JustCryen/STM32-HID-H.O.T.A.S/docs/Schematic-HOTAS-page1.png

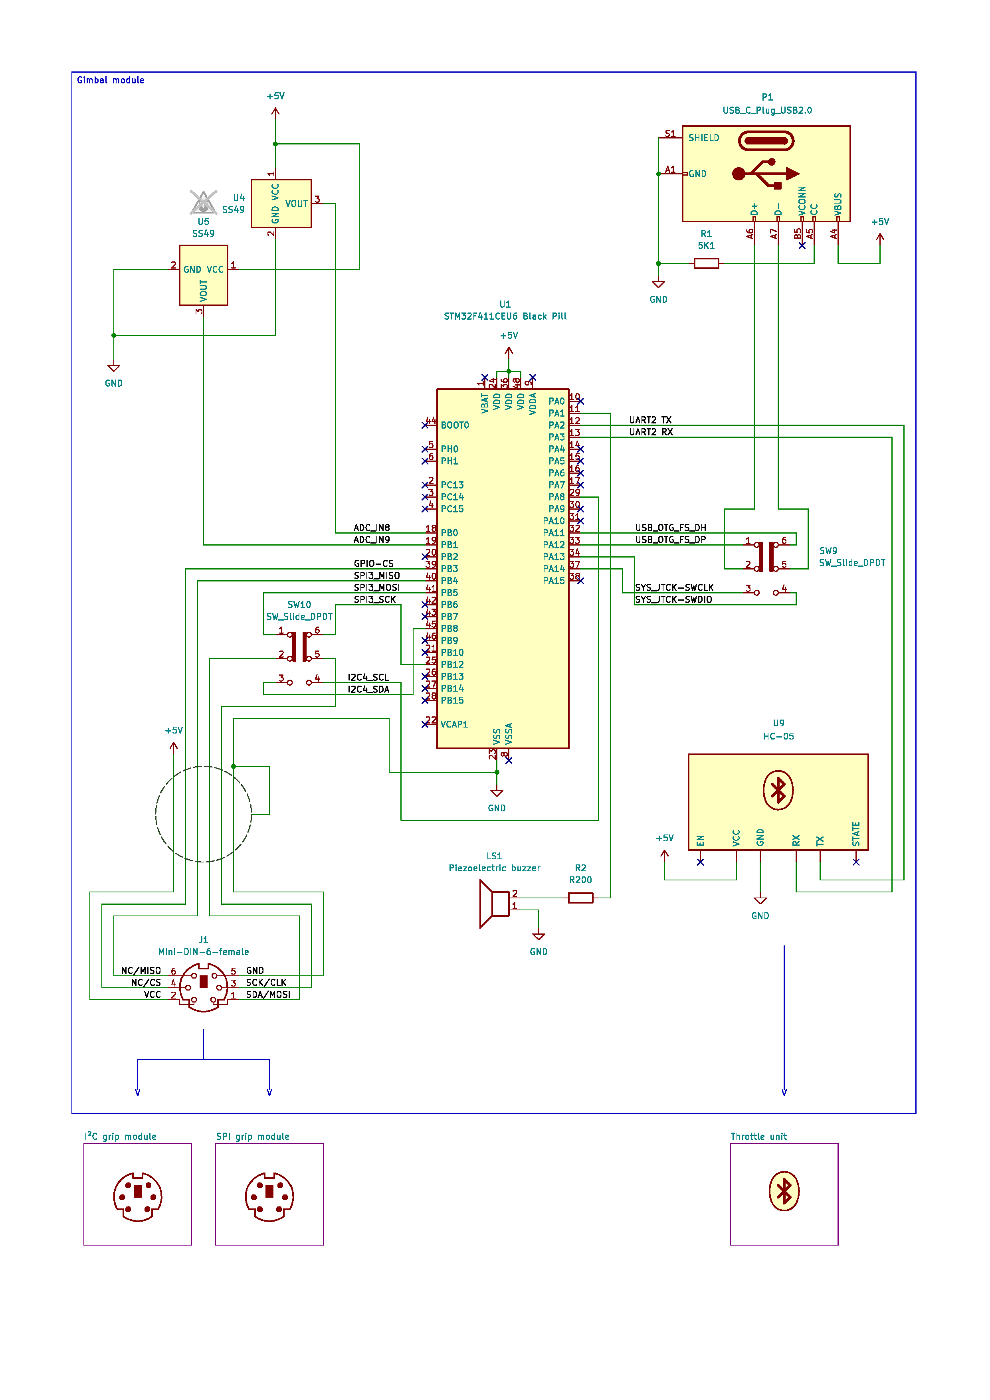
docs/Schematic-HOTAS-page1.png
