JustCryen/STM32-HID-H.O.T.A.S/docs/Schematic-HOTAS-page2.png

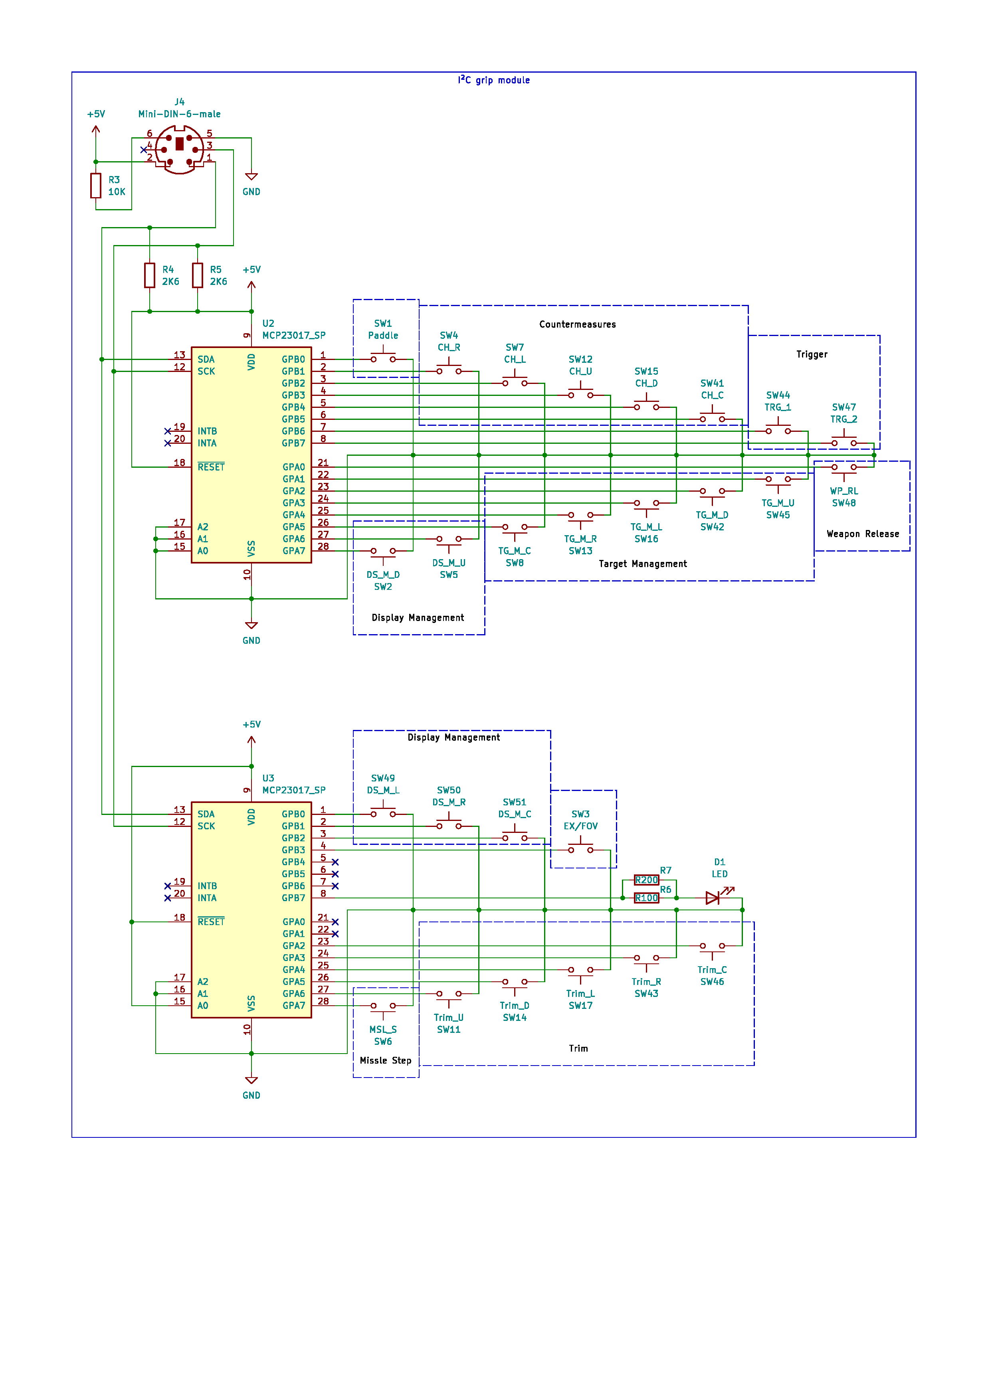
docs/Schematic-HOTAS-page2.png
