JustCryen/STM32-HID-H.O.T.A.S/docs/Schematic-HOTAS-page3.png

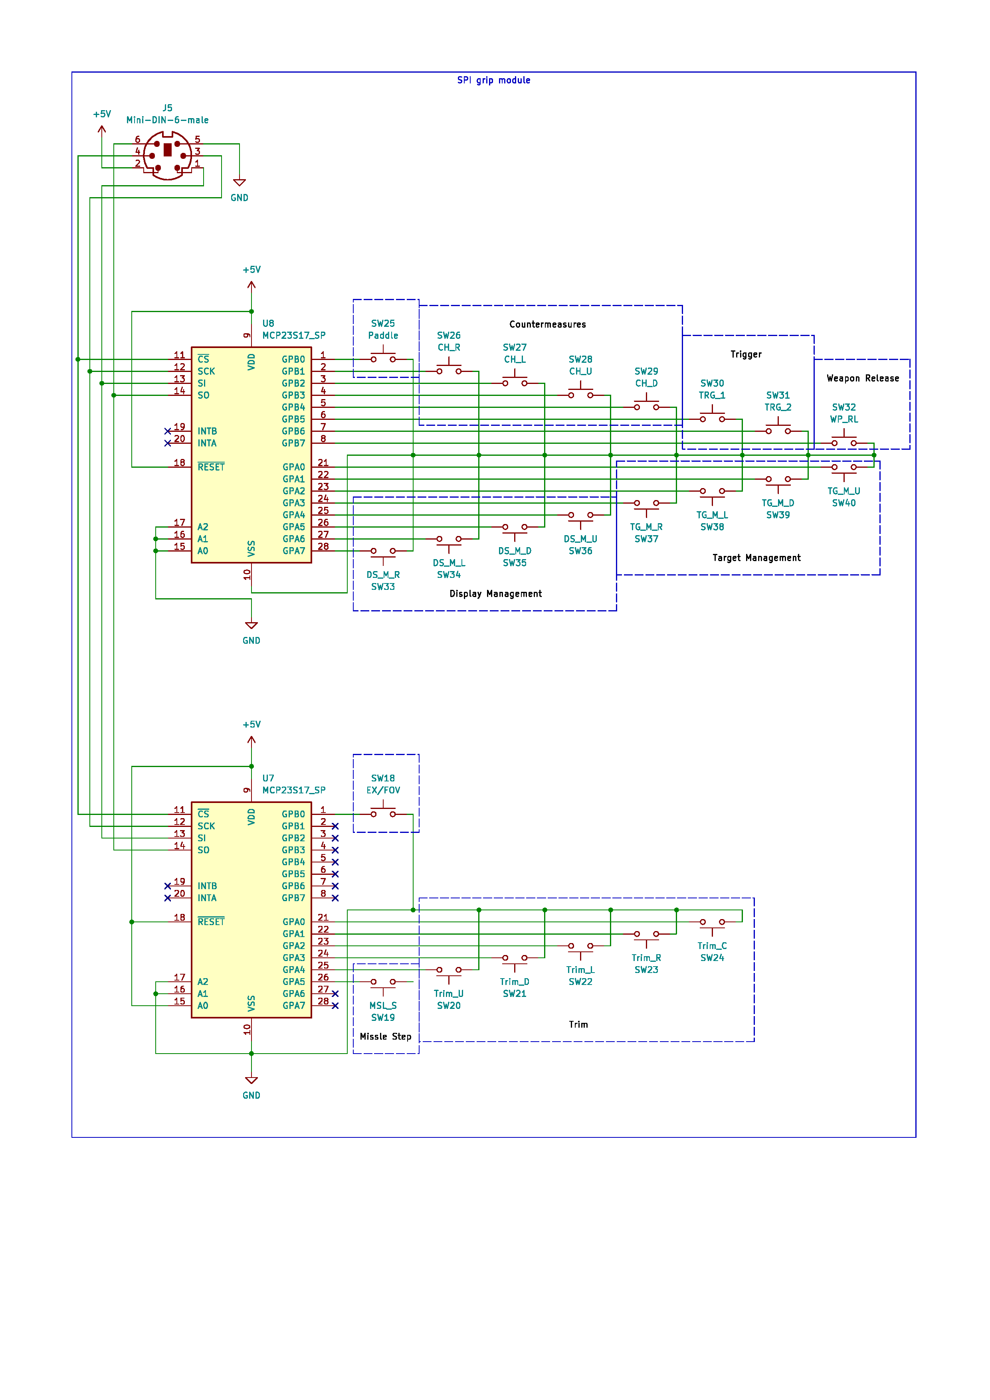
docs/Schematic-HOTAS-page3.png
