JustCryen/STM32-HID-H.O.T.A.S/docs/Schematic-HOTAS-page4.png

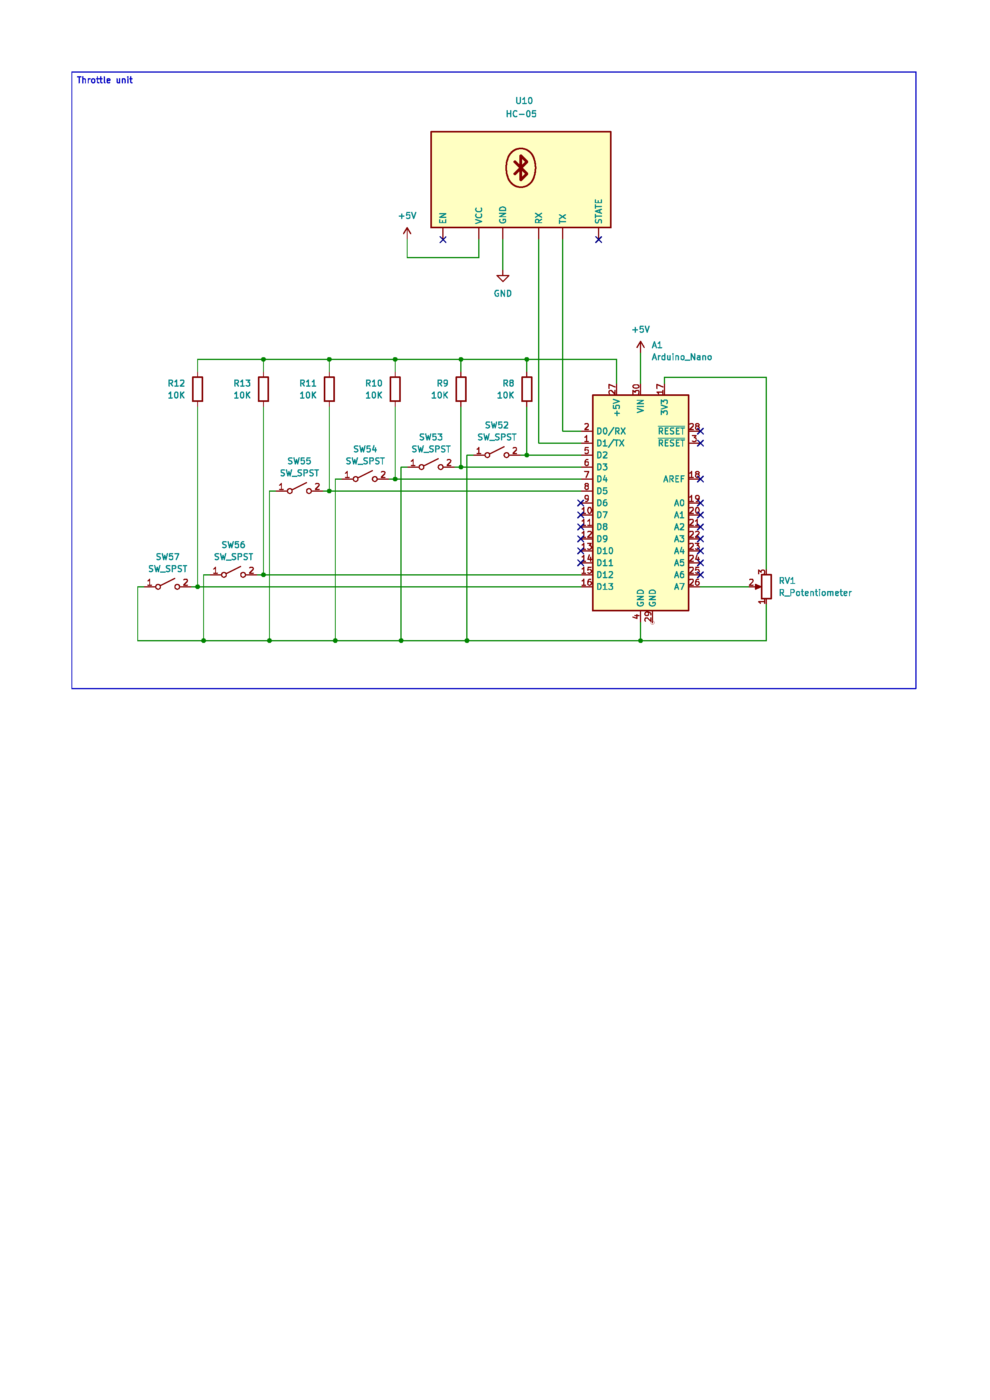
docs/Schematic-HOTAS-page4.png
