JustCryen/STM32-HID-H.O.T.A.S/docs/Schematic-HOTAS.pdf

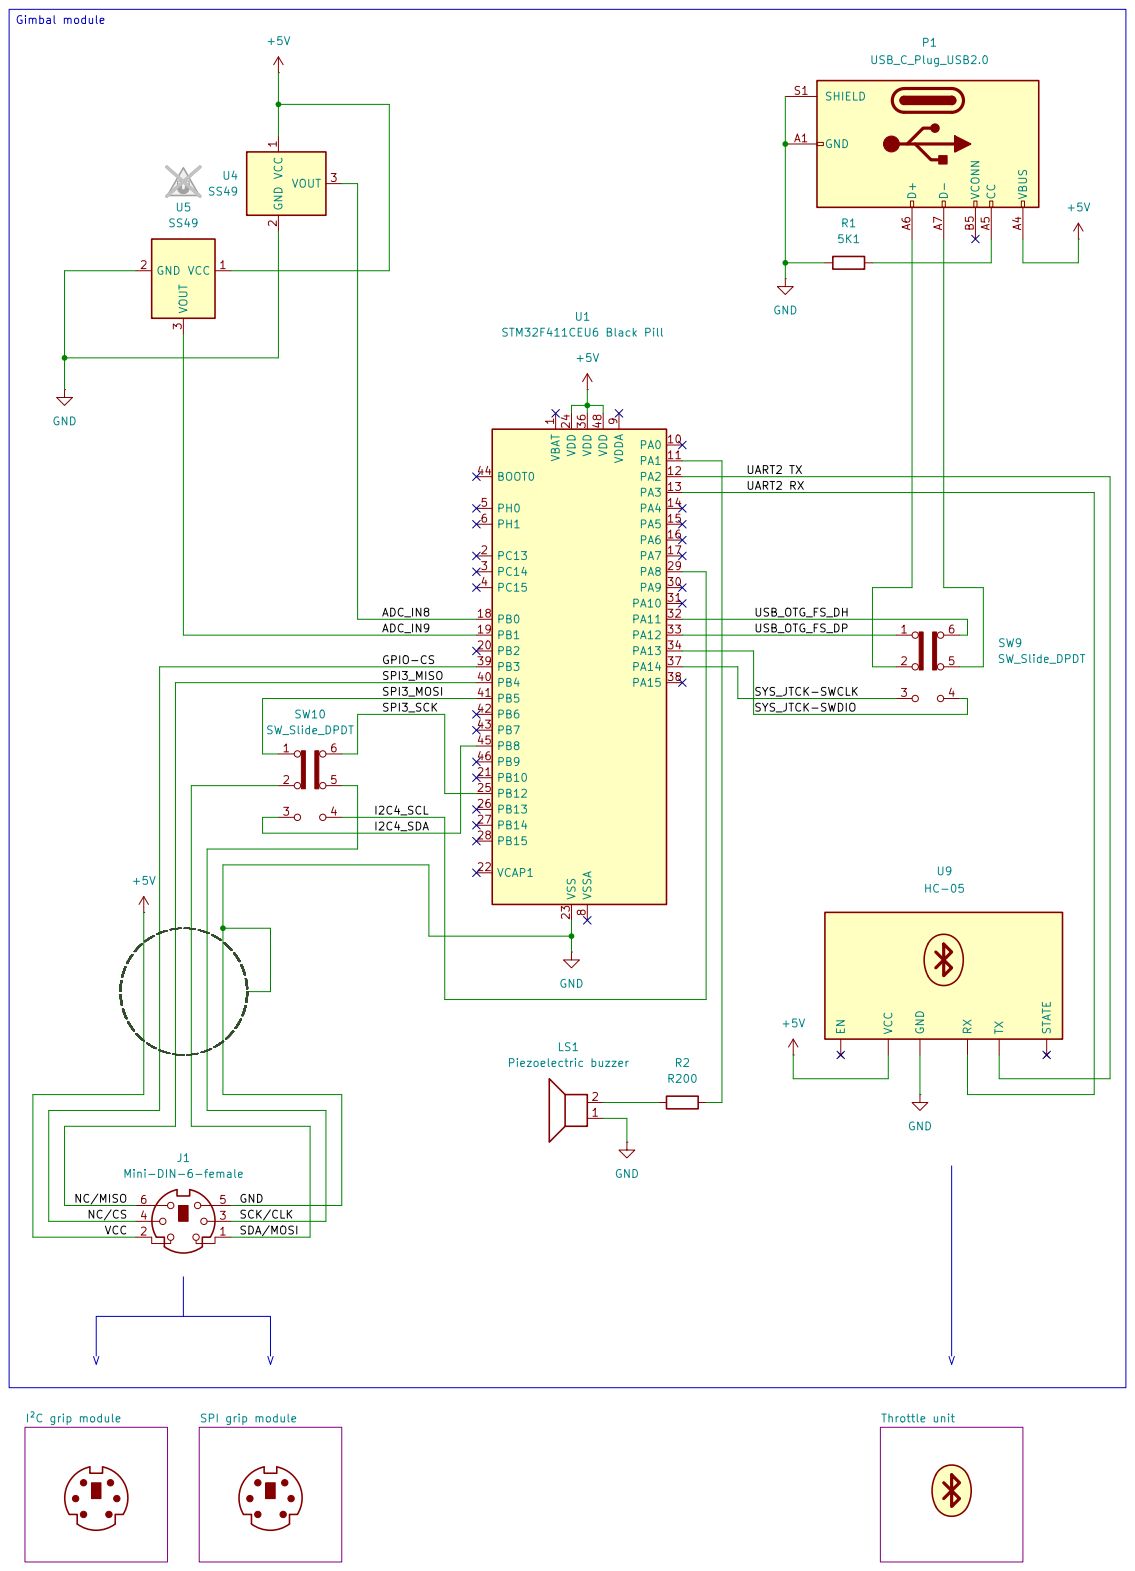
[picture p5: page 1]

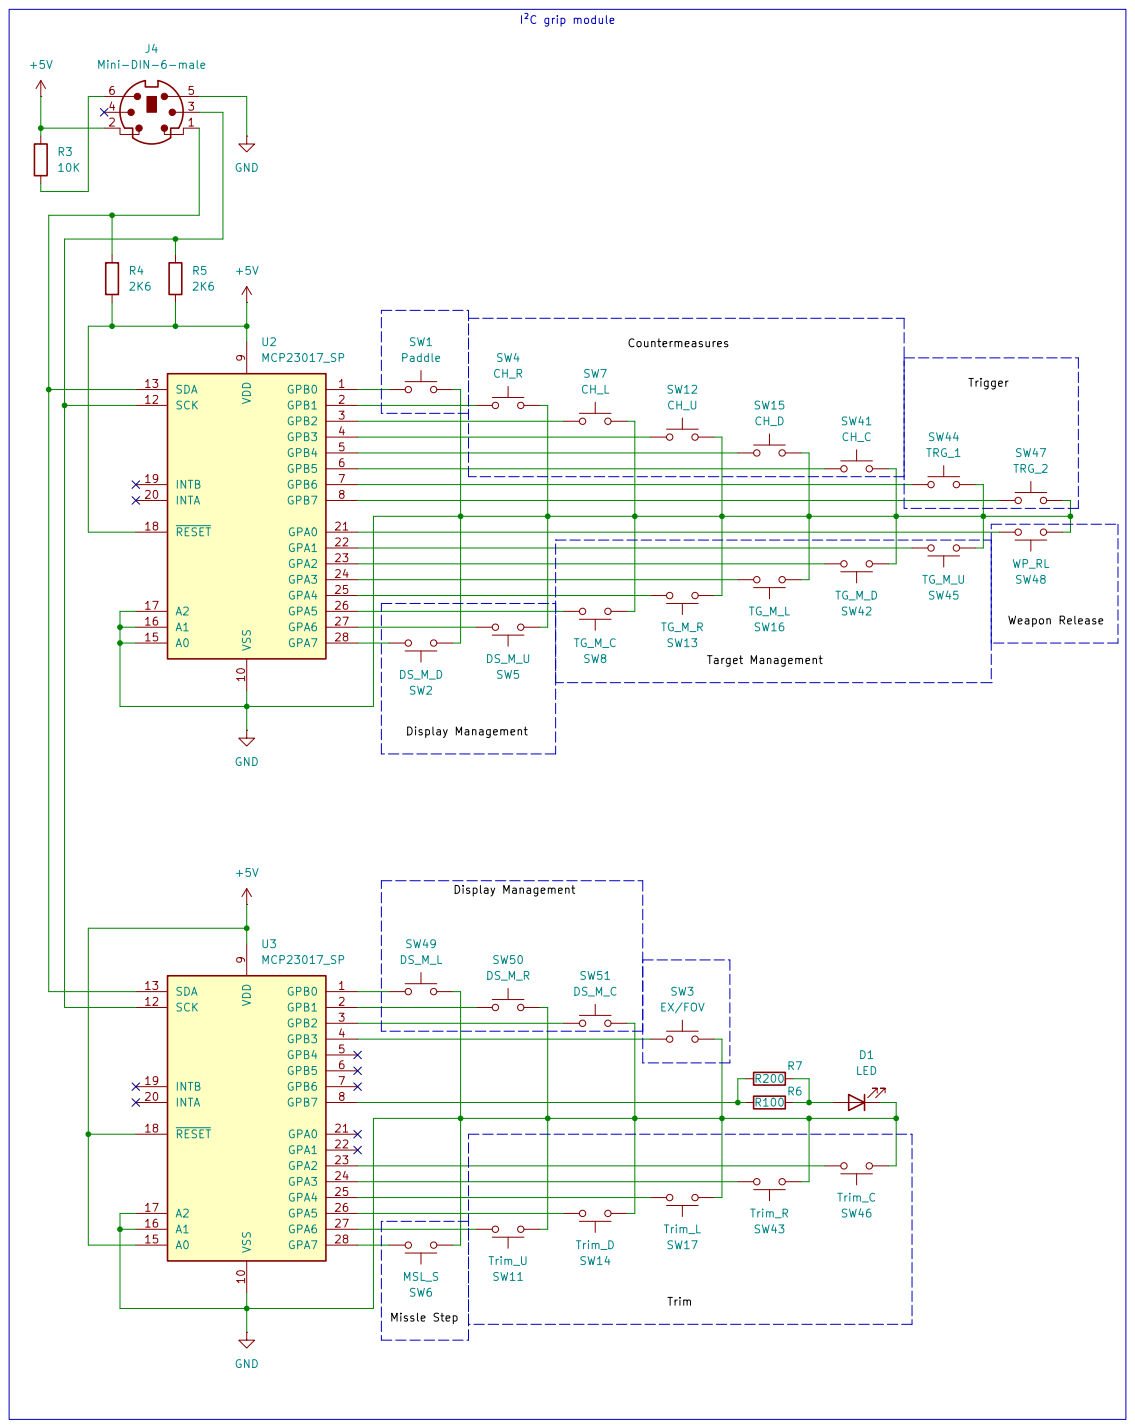
[picture p6: page 2]

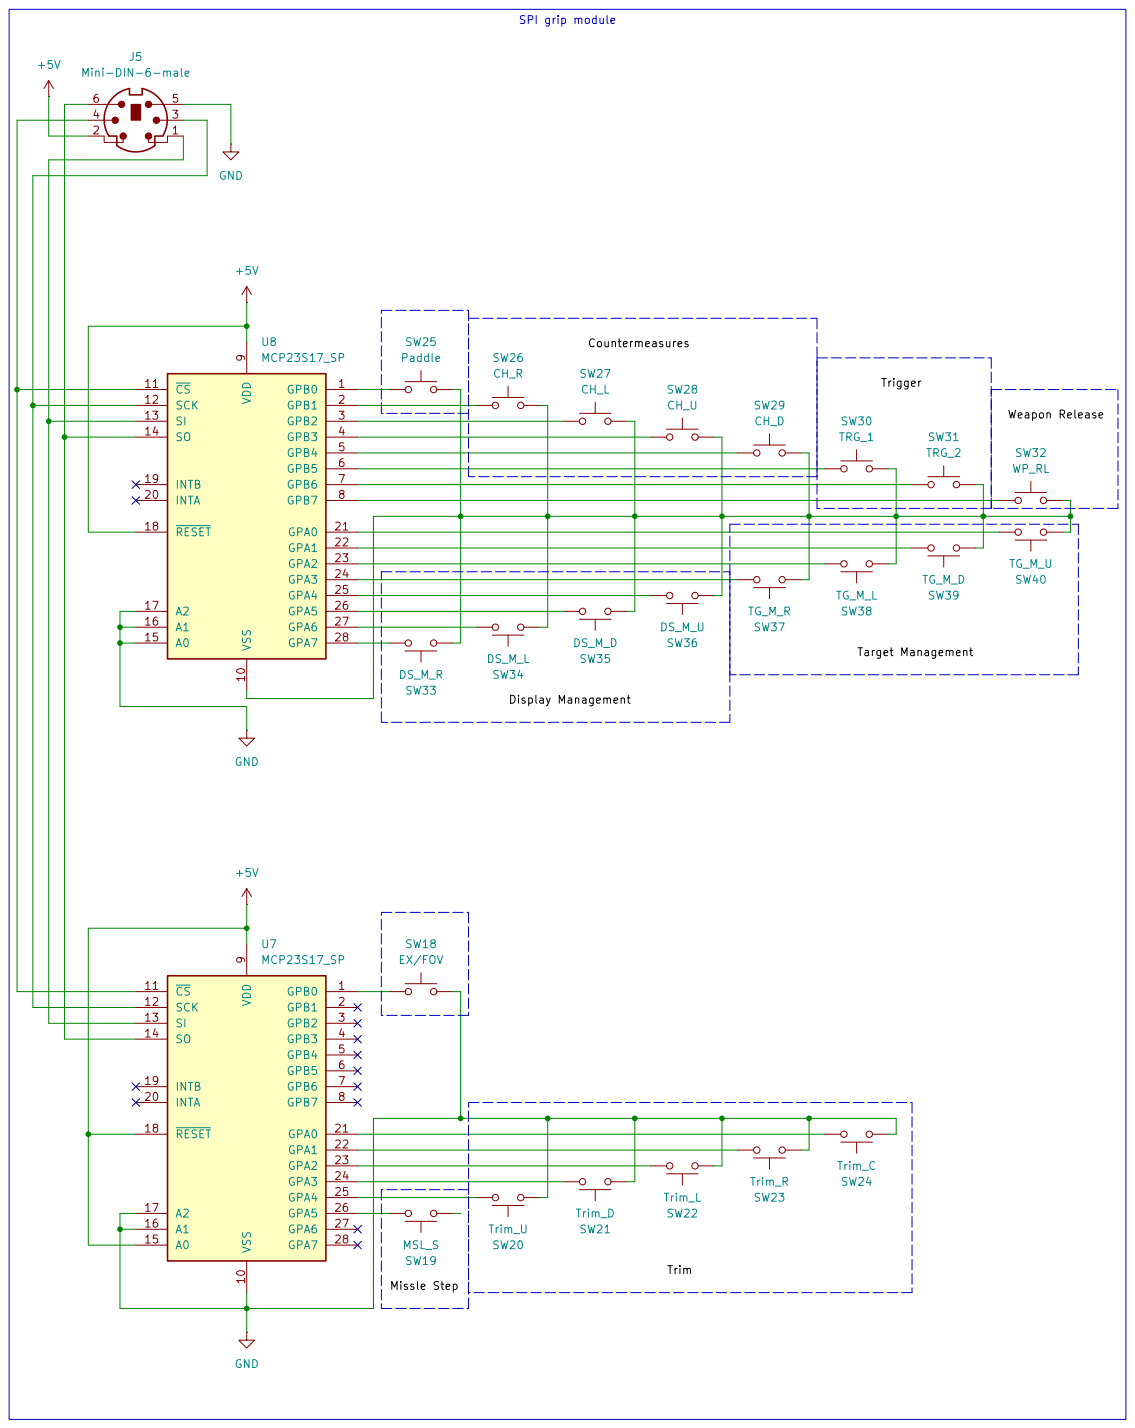
[picture p7: page 3]

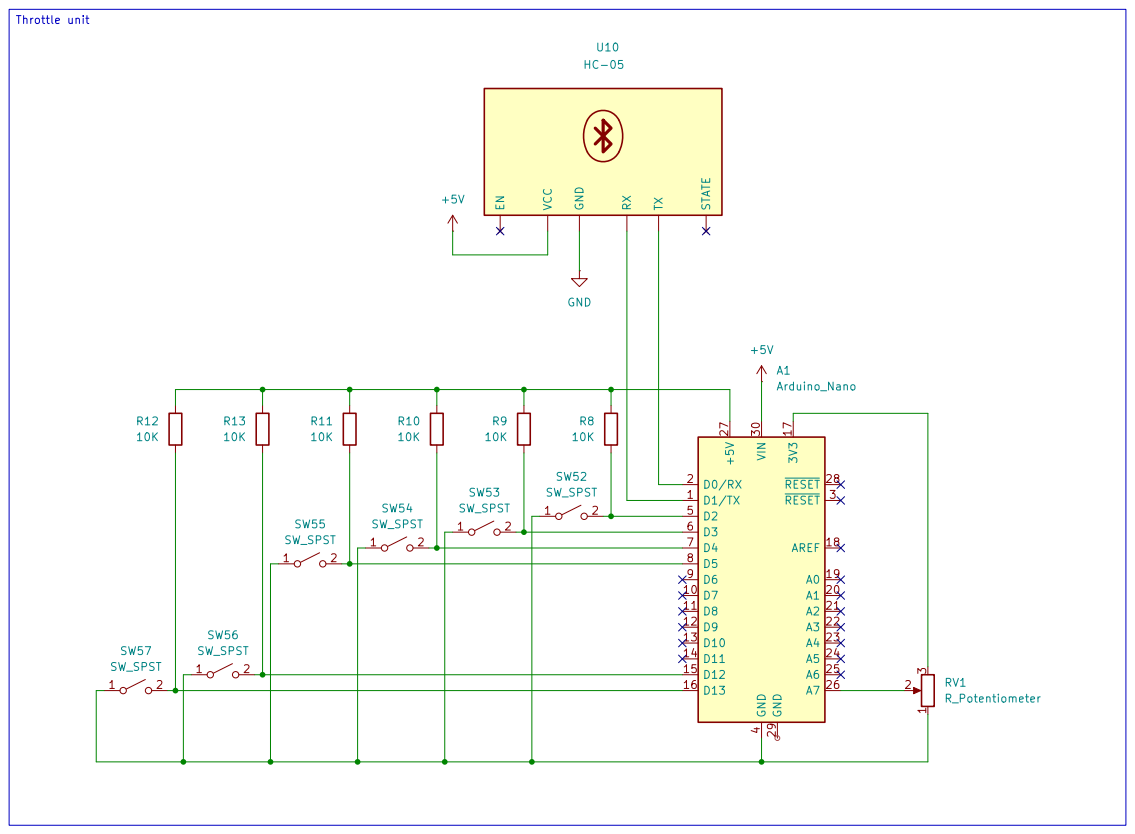
[picture p8: page 4]
