JustCryen/STM32-HID-H.O.T.A.S/HID-Hotas/Core/Src/main.c

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
/* Includes ------------------------------------------------------------------*/
#include "main.h"
#include "adc.h"
#include "dma.h"
#include "i2c.h"
#include "spi.h"
#include "tim.h"
#include "usart.h"
#include "usb_device.h"
#include "gpio.h"

/* USER CODE BEGIN Includes */
// #define serial_MCP23S17
// #define serial_MCP23017
#include "tunes.c"
#include "serial.c"
#include "usbd_customhid.h"
#include "math.h"
/* USER CODE END Includes */


/* USER CODE BEGIN PV */
uint16_t ADC_buffer[2];
/* USER CODE END PV */

void SystemClock_Config(void);
/* USER CODE BEGIN 0 */
extern USBD_HandleTypeDef hUsbDeviceFS;

int centering(uint16_t probed, uint16_t correction)
{
  uint16_t result;
  if (probed < correction)
  {
    result = (4095 - (((probed - 1056)* 2048) / (correction - 1056)));
  }
  else
  {
    result = (4095 - ((((probed - correction)* 2048) / (4095 - correction)) + 2048));
  }
  return result;
}
int expo(uint16_t probed2, uint16_t correction2)
{
  uint16_t x = centering(probed2, correction2);
  uint16_t result2;
  if (abs(x-2048) < 64)
  {
	result2 = 2048/16;
  }
  else
  {
	if (x > 2048)
	{
		result2 = ( 64 * exp((( x)-2048) / (510.0) ) + 2048)/16;
		if (result2 > 255) result2 = 255;
	}
	else
	{
		result2 = (-64 * exp(((-x)+2048) / (510.0) ) + 2048)/16;
	}
  }
  return result2;
}
/* USER CODE END 0 */

/**
  * @brief  The application entry point.
  * @retval int
  */
int main(void)
{
  /* USER CODE BEGIN 1 */
  uint8_t Joystick_buffer[7];
  uint8_t Extender_raw[4];
  uint16_t x_correction;
  uint16_t y_correction;
  uint8_t ThrottleBT[5] = {0};
  uint16_t Throttle = 0x00;
  uint16_t ThrottleButtons = 0xFF;
  uint16_t heartbit_delay = 50;
  /* USER CODE END 1 */

  /* MCU Configuration--------------------------------------------------------*/

  /* Reset of all peripherals, Initializes the Flash interface and the Systick. */
  HAL_Init();

  /* Configure the system clock */
  SystemClock_Config();

  /* Initialize all configured peripherals */
  MX_GPIO_Init();
  MX_DMA_Init();
  MX_USB_DEVICE_Init();
  MX_ADC1_Init();
  MX_SPI3_Init();
  MX_USART2_UART_Init();
  MX_I2C3_Init();
  MX_TIM4_Init();
  /* USER CODE BEGIN 2 */

  Joystick_buffer[0] = 0; // T
  Joystick_buffer[1] = 0; // X
  Joystick_buffer[2] = 0; // Y
  Joystick_buffer[3] = 0; // Extender
  Joystick_buffer[4] = 0; // Extender
  Joystick_buffer[5] = 0; // Extender
  Joystick_buffer[6] = 0; // Extender
  HAL_TIM_PWM_Start(&htim4, TIM_CHANNEL_4);
  tune_init();
  HAL_ADC_Start_DMA(&hadc1, (uint32_t*) ADC_buffer, 2);
  HAL_Delay(1000);
  x_correction = ADC_buffer[0];
  y_correction = ADC_buffer[1];
  setup_MCP23X17();
  if (protocol) {
	MCP23X17_write(IO_DEVICE_1, MCP_OLATB, 0x40);
  }
  /* USER CODE END 2 */

  /* Infinite loop */
  /* USER CODE BEGIN WHILE */
  while (1)
  {
    /* USER CODE END WHILE */

    /* USER CODE BEGIN 3 */
    if (heartbit_delay > 0)
	  heartbit_delay -= 1;
	else {
      tune_heartbeat();
	  heartbit_delay = 100;
	}

    if (HAL_GPIO_ReadPin(GPIOA, GPIO_PIN_0) == 0) {
	  setup_MCP23017();
      x_correction = ADC_buffer[0];
      y_correction = ADC_buffer[1];
	  tune_calibrated();
	}

    HAL_UART_Receive_DMA(&huart2, ThrottleBT, 5);
    if (ThrottleBT[0] == 'z')				// detect Z axis data packet
    {
      ThrottleBT[0] = '0';					// rewrite x as 0 to be able to convert char to int
      Throttle = atoi((char*) ThrottleBT);
    } else if (ThrottleBT[0] == 'b')		// detect buttons data packet
    {
      ThrottleBT[0] = '0';
      ThrottleButtons = atoi((char*) ThrottleBT);
    //   ThrottleB2 = ThrottleBT[2];
    //   ThrottleB3 = ThrottleBT[3];
    //   ThrottleB4 = ThrottleBT[4];
    }
    Extender_raw[0] = MCP23X17_read(IO_DEVICE_1, MCP_GPIOA);
    Extender_raw[1] = MCP23X17_read(IO_DEVICE_1, MCP_GPIOB);
    Extender_raw[2] = MCP23X17_read(IO_DEVICE_2, MCP_GPIOA);
    Extender_raw[3] = MCP23X17_read(IO_DEVICE_2, MCP_GPIOB);
    uint8_t Extender_data[4] = {0};

    for(int index = 0; index < 32; index++)
    {
      InputIndexing *input_loc = input_map + index;
      int Extender_value = (Extender_raw[input_loc->byte_index] >> input_loc->bit_index) & 0x1;
      int curr_byte_index = index / 8;
      int curr_bit_index  = index % 8;
      Extender_data[curr_byte_index] |= Extender_value << curr_bit_index;
    }

    HAL_ADC_Start_DMA(&hadc1, (uint32_t*) ADC_buffer, 2);
    Joystick_buffer[0] = Throttle/4;
    Joystick_buffer[1] = expo(ADC_buffer[0], x_correction);
    Joystick_buffer[2] = expo(ADC_buffer[1], y_correction);
    Joystick_buffer[3] = Extender_data[0];
    Joystick_buffer[4] = Extender_data[1];
    Joystick_buffer[5] = Extender_data[2];
    Joystick_buffer[6] = (~ThrottleButtons & 0x3F) << 2 |	// insert 6 buttons from the throttle
                         (Extender_data[3] & 0x03);
    USBD_CUSTOM_HID_SendReport(&hUsbDeviceFS, Joystick_buffer, 7);
    HAL_Delay(50);
  }
  /* USER CODE END 3 */
}

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
