JustCryen/STM32-HID-H.O.T.A.S/HID-Hotas/HID-Hotas.ioc

Mcu.UserName=STM32F411CEUx
PA0-WKUP.Signal=GPIO_Input
PA1.Signal=GPIO_Output
PA11.Signal=USB_OTG_FS_DM
PA12.Signal=USB_OTG_FS_DP
PA13.Signal=SYS_JTMS-SWDIO
PA14.Signal=SYS_JTCK-SWCLK
PA2.Signal=USART2_TX
PA3.Signal=USART2_RX
PA8.Signal=I2C3_SCL
PB0.Signal=ADCx_IN8
PB1.Signal=ADCx_IN9
PB12.Signal=SPI3_SCK
PB3.Signal=GPIO_Output
PB4.Signal=SPI3_MISO
PB5.Signal=SPI3_MOSI
PB8.Signal=I2C3_SDA
PB9.Signal=S_TIM4_CH4
