JustCryen/STM32-HID-H.O.T.A.S/(commit log)

2022-10-23 Initial Commit
    Mostly clean MCU configuration with early stages of HID communication added.
2022-10-27 Added debugging in vscodium using cortex-debug
    [stlink.cfg, stm32f4x.cfg]
2022-10-28 Added analog scaling for SS49E Hall sensors
2022-10-29 Added support for MCP23S17 I/O Expander over SPI
2022-11-05 Rearranged pin bindings
2022-11-11 Debug SPI
2022-11-11 Fixed Analog on B0 & B1
    [HID-Hotas.ioc, main.c]
2022-12-30 Wiring cleanup
2022-12-31 Added Throttle axis with a temporary value
2023-01-01 Throttle over Bluetooth is now functional
2023-01-01 Simplified Throttle data conversion
2023-01-05 Added throttle unit code to the repo (Arduino) Removed OpenOCD as it wasn't used
    [stlink.cfg, stm32f4x.cfg]
2023-01-22 Cleanup & Windows fix
    [HID-Hotas.ioc, HOTAS-Throttle-unit.ino, main.c]
2024-06-08 Separated SPI code, getting ready for I²C
2024-06-09 Routed I²C pins and slowed down SPI
2024-06-09 Autoswitch SPI - I²C
2024-08-05 added piezo on pin B9 & calibrate with A0
2024-08-08 New input_map and correct output bit set for I2C
    [HID-Hotas.ioc, main.c]
2024-08-17 disable pull-ups on I2C
2024-08-22 Extended grip buttons from 23 to 26
2024-09-02 Buttons on throttle handled
2024-09-02 Extended throttle from 4 to 6 buttons
2024-09-03 Arduino throttle unit expanded
2025-03-10 Added a schematic
